KG691/SkolniMeteostanice/pcb_files/BOM.pdf

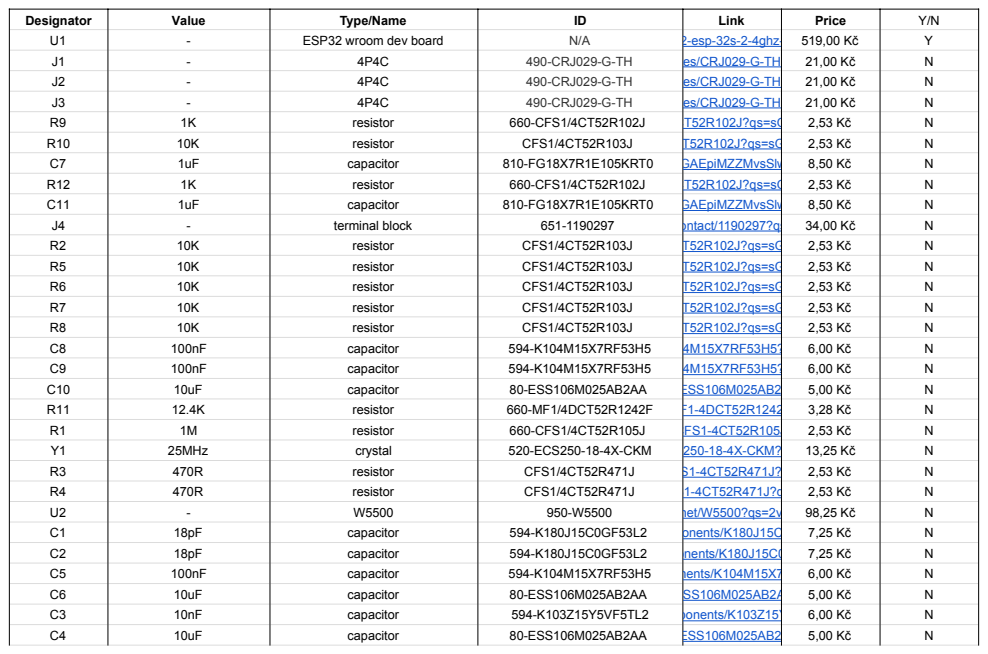
[picture p1: page 1]

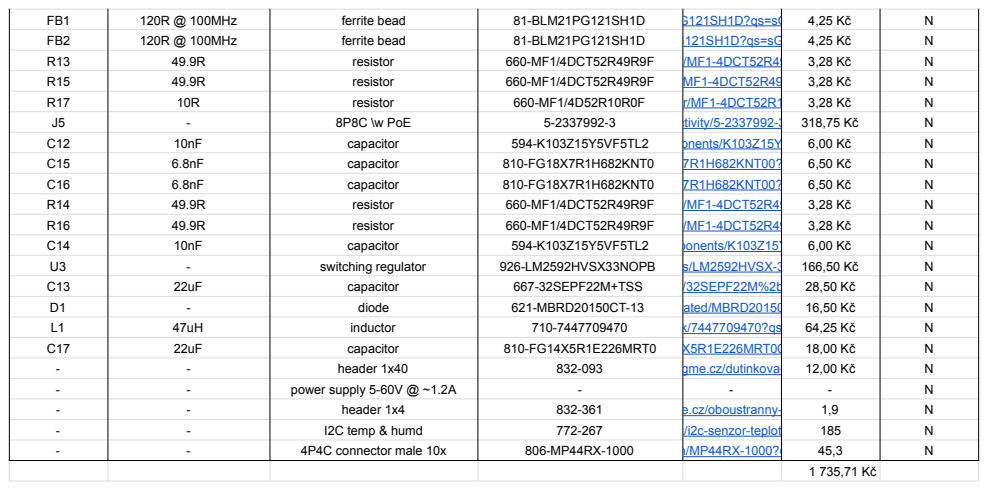
[picture p2: page 2]
