KG691/SkolniMeteostanice/pcb_files/school_meteo.kicad_pcb

## KiCad design pcb_files/school_meteo.kicad_pcb (2022-08-02)

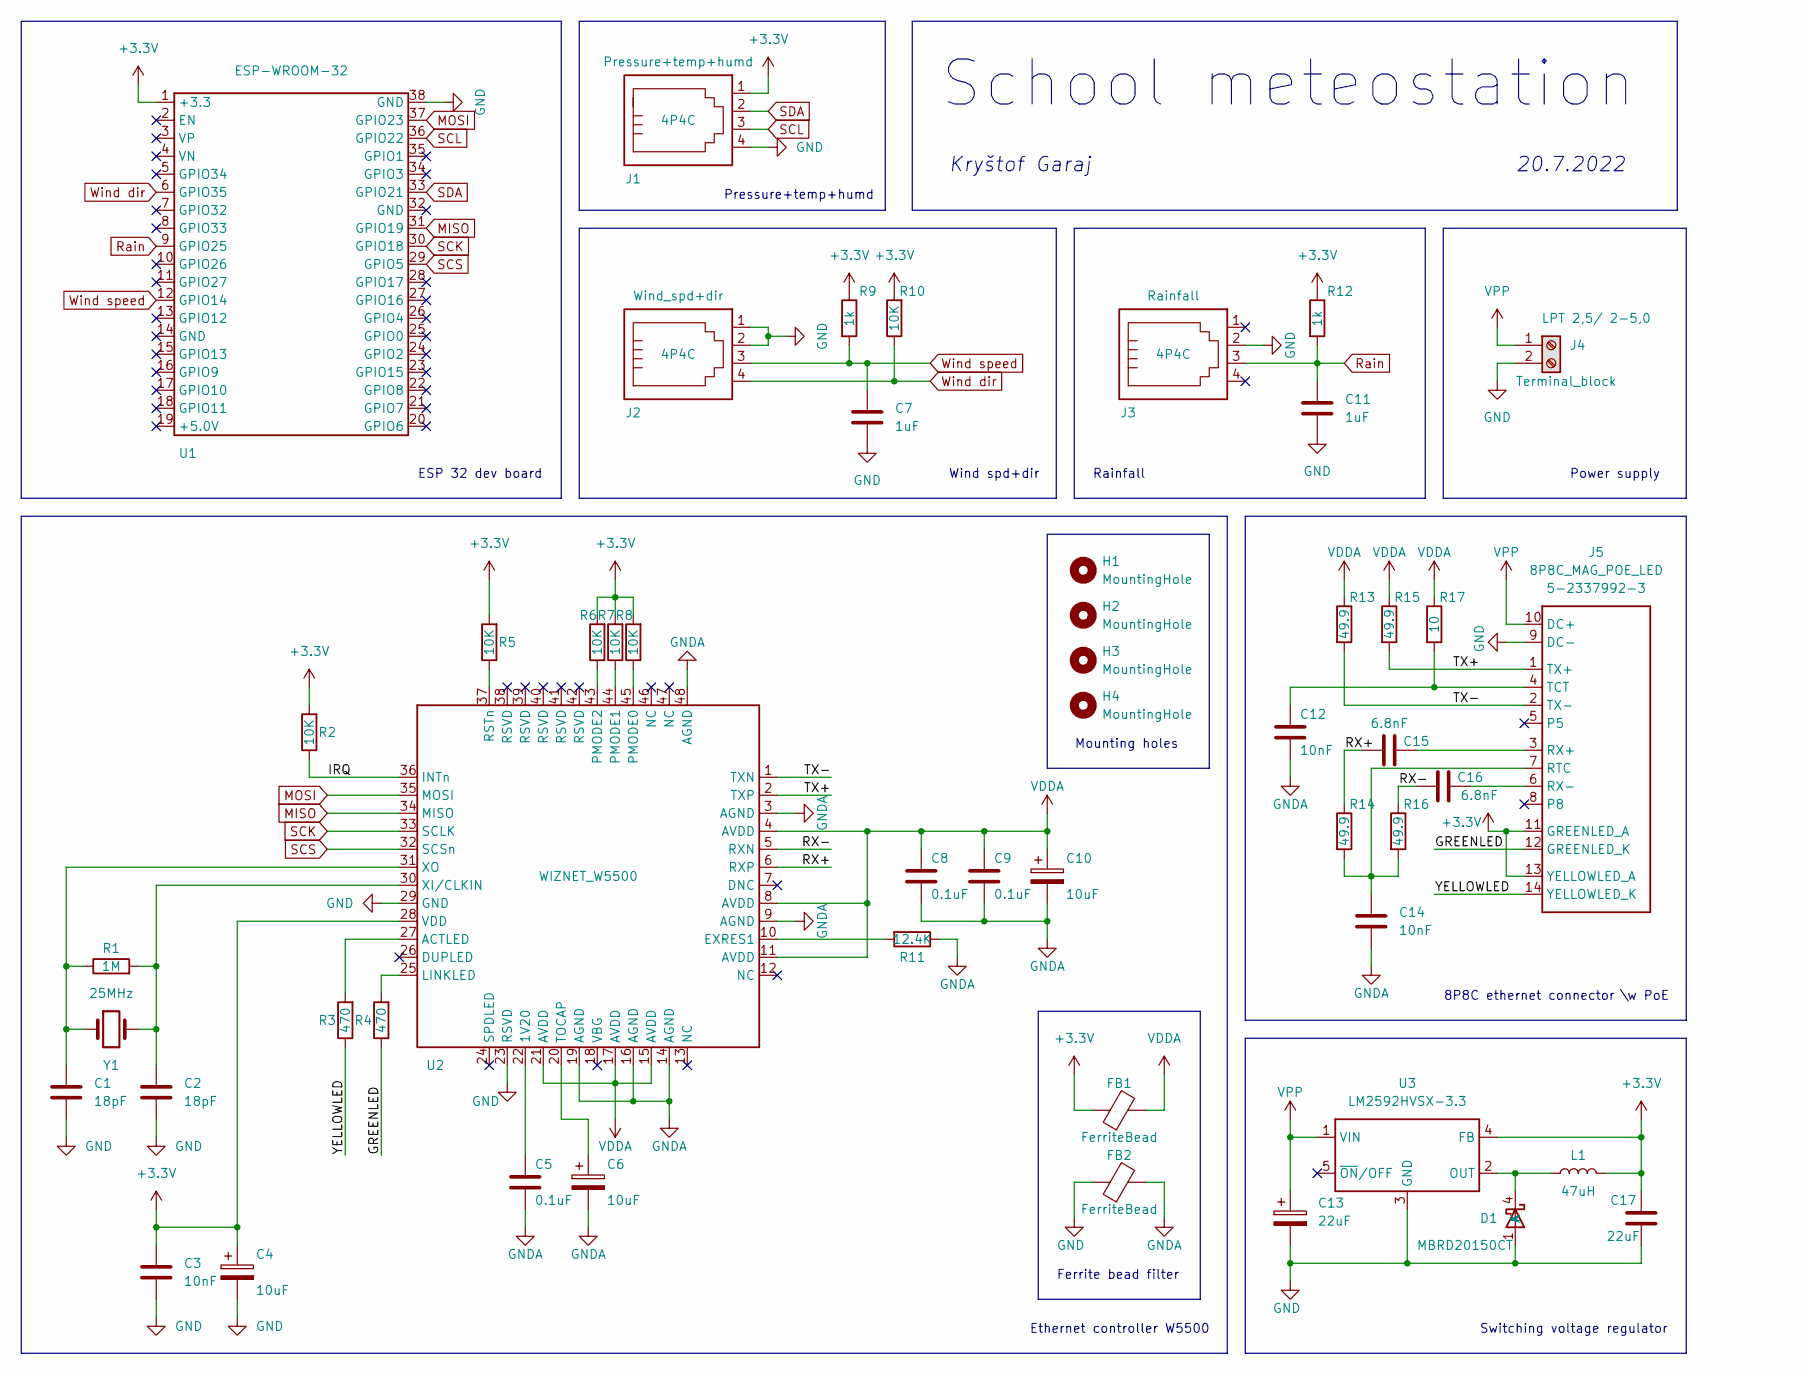
[picture p3: schematic school_meteo.kicad_sch]

Parts:
C1, C2: 18pF; C_Rect_L4.6mm_W3.0mm_P2.50mm_MKS02_FKP02
C3, C12, C14: 10nF; C_Rect_L4.6mm_W3.0mm_P2.50mm_MKS02_FKP02
C4, C6, C10: 10uF; CP_Radial_D5.0mm_P2.00mm
C5, C8, C9: 0.1uF; C_Rect_L4.6mm_W3.0mm_P2.50mm_MKS02_FKP02
C7, C11: 1uF; C_Rect_L4.6mm_W3.8mm_P2.50mm_MKS02_FKP02
C13: 22uF; CP_Radial_D6.3mm_P2.50mm
C15, C16: 6.8nF; C_Rect_L4.6mm_W3.0mm_P2.50mm_MKS02_FKP02
C17: 22uF; C_Rect_L4.6mm_W3.0mm_P2.50mm_MKS02_FKP02
D1: MBRD20150CT; TO-252-3_TabPin4
FB1, FB2: FerriteBead; Ferrite_bead_0805
H1, H2, H3, H4: MountingHole; MountingHole_3.2mm_M3_DIN965_Pad
J1, J2, J3: 4P4C
J4: Terminal_block; Phoenix_LPT_2,5_2-5,0
J5: 8P8C_MAG_POE_LED; TE_Connectivity_PoE
L1: 47uH; L_12x12mm_H8mm
R1: 1M; R_Axial_DIN0204_L3.6mm_D1.6mm_P5.08mm_Horizontal
R2, R5, R6, R7, R8, R10: 10K; R_Axial_DIN0204_L3.6mm_D1.6mm_P5.08mm_Horizontal
R3, R4: 470; R_Axial_DIN0204_L3.6mm_D1.6mm_P5.08mm_Horizontal
R9, R12: 1k; R_Axial_DIN0204_L3.6mm_D1.6mm_P5.08mm_Horizontal
R11: 12.4K; R_Axial_DIN0207_L6.3mm_D2.5mm_P7.62mm_Horizontal
R13, R14, R15, R16: 49.9; R_Axial_DIN0207_L6.3mm_D2.5mm_P7.62mm_Horizontal
R17: 10; R_Axial_DIN0207_L6.3mm_D2.5mm_P7.62mm_Horizontal
U1: ESP-WROOM-32
U2: WIZNET_W5500; LQFP-48_7x7mm_P0.5mm
U3: LM2592HVSX-3.3; TO-263-5_TabPin3
Y1: 25MHz; Crystal_HC49-U_Vertical

Connections:
+3V3: C3.1, C4.1, C17.2, FB1.1, J1.1, J5.11 (GREENLED_A), J5.13 (YELLOWLED_A), L1.2, R2.2, R5.2, R6.2, R7.2, R8.2, R9.1, R10.2, R12.1, U1.1 (+3.3), U2.28 (VDD), U3.4 (FB)
/GREENLED: J5.12 (GREENLED_K), R4.1
/IRQ: R2.1, U2.36 (INTn)
/RX+: C15.1, R14.1, U2.6 (RXP)
/RX-: C16.1, R16.1, U2.5 (RXN)
/TX+: J5.1 (TX+), R15.2, U2.2 (TXP)
/TX-: J5.2 (TX-), R13.2, U2.1 (TXN)
/YELLOWLED: J5.14 (YELLOWLED_K), R3.1
GND: C1.2, C2.2, C3.2, C4.2, C7.2, C11.2, C13.2, C17.1, D1.1 (A), FB2.1, J1.4, J2.1, J2.2, J3.2, J4.2, J5.9 (DC-), U1.38 (GND), U2.23 (RSVD), U2.29 (GND), U3.3 (GND)
GNDA: C5.2, C6.2, C8.2, C9.2, C10.2, C12.2, C14.2, FB2.2, R11.1, U2.3 (AGND), U2.9 (AGND), U2.14 (AGND), U2.16 (AGND), U2.19 (AGND), U2.48 (AGND)
MISO: U1.31 (GPIO19), U2.34 (MISO)
MOSI: U1.37 (GPIO23), U2.35 (MOSI)
unnamed: C1.1, R1.1, U2.31 (XO), Y1.1
unnamed: C2.1, R1.2, U2.30 (XI/CLKIN), Y1.2
unnamed: C5.1, U2.22 (1V20)
unnamed: C6.1, U2.20 (TOCAP)
unnamed: C12.1, J5.4 (TCT), R17.2
unnamed: C14.1, J5.7 (RTC), R14.2, R16.2
unnamed: C15.2, J5.3 (RX+)
unnamed: C16.2, J5.6 (RX-)
unnamed: D1.4 (K), L1.1, U3.2 (OUT)
unnamed: R3.2, U2.27 (ACTLED)
unnamed: R4.2, U2.25 (LINKLED)
unnamed: R5.1, U2.37 (RSTn)
unnamed: R6.1, U2.43 (PMODE2)
unnamed: R7.1, U2.44 (PMODE1)
unnamed: R8.1, U2.45 (PMODE0)
unnamed: R11.2, U2.10 (EXRES1)
Rain: C11.1, J3.3, R12.2, U1.9 (GPIO25)
SCK: U1.30 (GPIO18), U2.33 (SCLK)
SCL: J1.3, U1.36 (GPIO22)
SCS: U1.29 (GPIO5), U2.32 (SCSn)
SDA: J1.2, U1.33 (GPIO21)
VDDA: C8.1, C9.1, C10.1, FB1.2, R13.1, R15.1, R17.1, U2.4 (AVDD), U2.8 (AVDD), U2.11 (AVDD), U2.15 (AVDD), U2.17 (AVDD), U2.21 (AVDD)
VPP: C13.1, J4.1, J5.10 (DC+), U3.1 (VIN)
Wind dir: J2.4, R10.1, U1.6 (GPIO35)
Wind speed: C7.1, J2.3, R9.2, U1.12 (GPIO14)

Notes on the sheet:
8P8C ethernet connector \w PoE
Kryštof Garaj
Wind spd+dir
Pressure+temp+humd
Power supply
Ferrite bead filter
Mounting holes
Ethernet controller W5500
Rainfall
Switching voltage regulator
School meteostation
ESP 32 dev board
20.7.2022

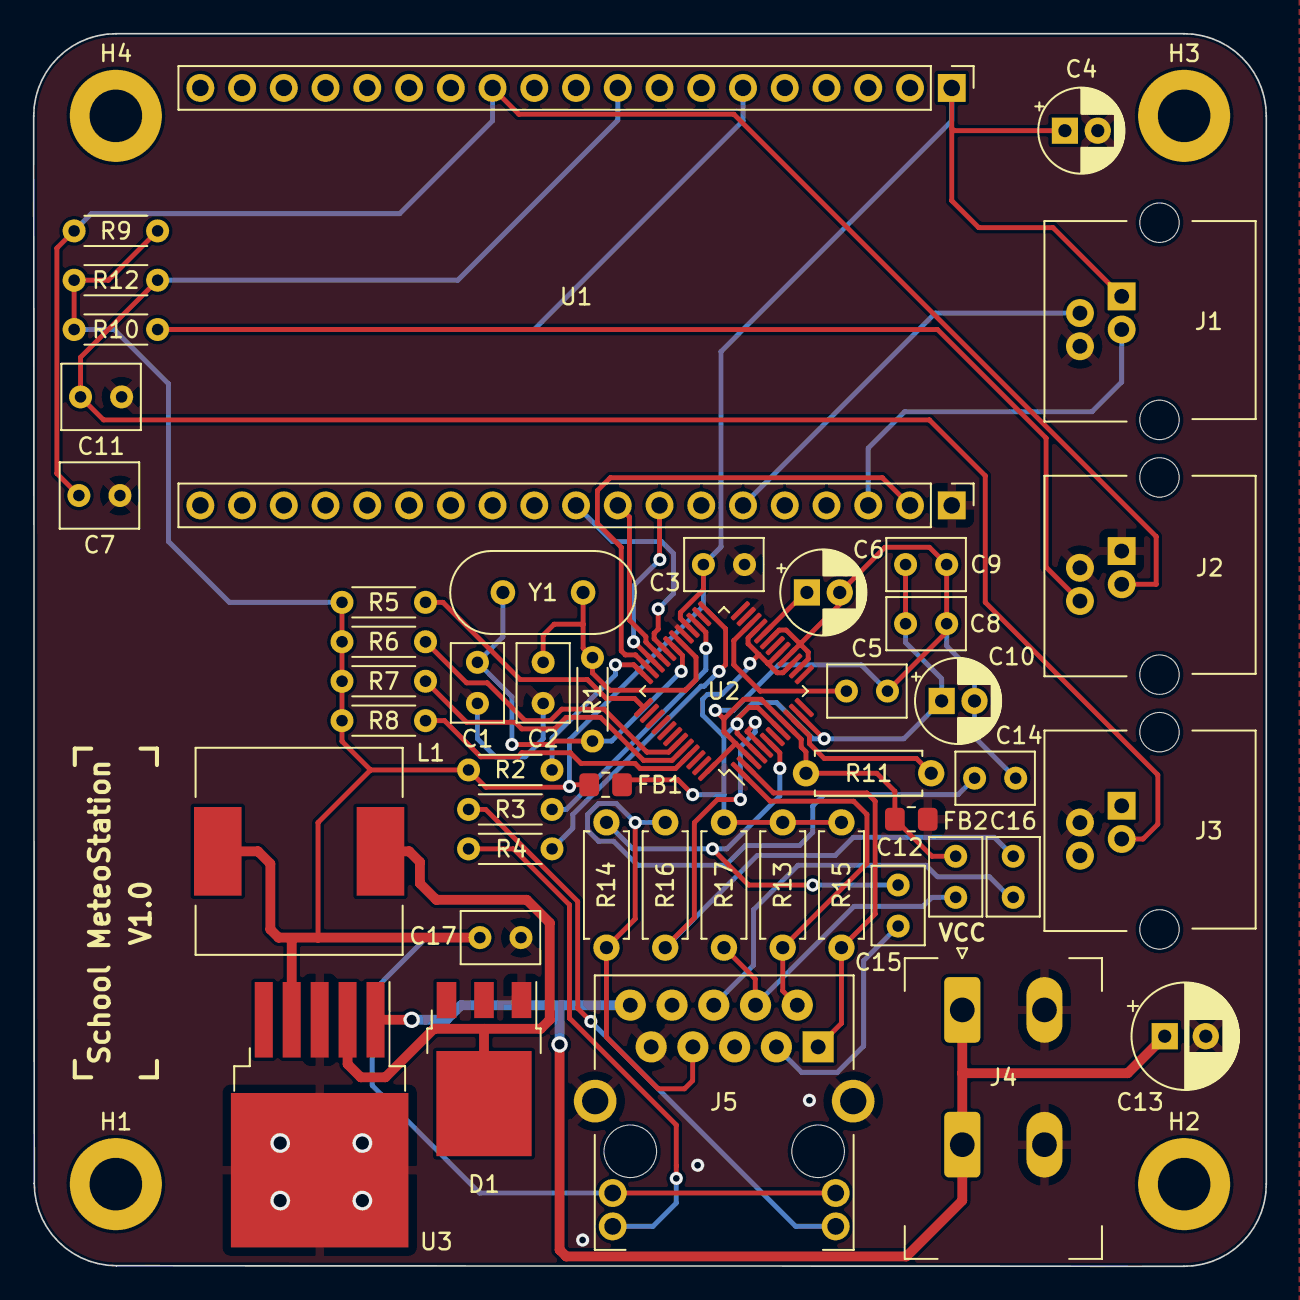
[picture p4: board school_meteo.kicad_pcb from above]

Board: 2 copper layers, 75.0 x 75.0 mm, 51 parts (0 on the bottom side), 37 nets.
