KG691/SkolniMeteostanice/(commit log)

2022-07-09 Changing the table for the wind direction
    Changing the table for the wind direction, since the old one was flipped
    [SchoolMeteo.ino]
2022-07-27 Create pcb_files
2022-07-27 Create school_meteo.kicad_sch
    Adding KiCad schematic
    [school_meteo.kicad_sch]
2022-08-02 Adding BOM
    Creating BOM with designators, values, types, IDs, links and prices of the parts
2022-08-02 Updating BOM
    Adding some parts
2022-08-02 Updating schematic
    Updating schematic
    [school_meteo.kicad_sch]
2022-08-02 Adding pcb layout
    Adding pcb layout
    [school_meteo.kicad_pcb]
2022-08-09 Minor changes
    Reverting unwanted changes
    [SchoolMeteo.ino]
2022-08-15 I2C and ESP32 better explanation
    Adding a more indepth explanation of how I2C works
2022-08-18 Change of temp+hum sensor for HTU21D GY-21
    Change of temp+hum sensor for HTU21D GY-21 to utilize I2C
2022-08-18 Adding unit for pressure
    Adding tested unit for pressure
2022-08-18 Adding a unit for pressure , humidity and temperature
    Adding a tested unit for pressure , humidity and temperature
2022-08-18 Adding unit for temperature and humidity
    Adding tested unit for temperature and humidity
2022-08-18 Adding unit for wind speed
    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
2022-08-21 Removing code used for DHT sensor
    Removing code used for DHT sensor because I'm using HTU21D GY-21 instead
2022-08-22 Adding gerber files
    Adding gerber files for the pcb
    [school_meteo-B_Cu.gbr, school_meteo-B_Mask.gbr, school_meteo-B_Paste.gbr, school_meteo-B_Silkscreen.gbr, school_meteo-Edge_Cuts.gbr, school_meteo-F_Cu.gbr, school_meteo-F_Mask.gbr, school_meteo-F_Paste.gbr]
2022-08-22 This library is not needed
    This library is not needed because I'm using a different sensor
2022-08-22 Adding library for the new sensor
    Adding library for the new sensor of temperature and humidity HTU21D
2022-08-22 Adding the link of the GyverHTU21D library
    Adding the link of the GyverHTU21D library for temperature and humidity
